hfedarovich/EECD_22_6_main/rc_helicopter_mainboard.kicad_pcb

## KiCad design rc_helicopter_mainboard.kicad_pcb (2023-01-17)

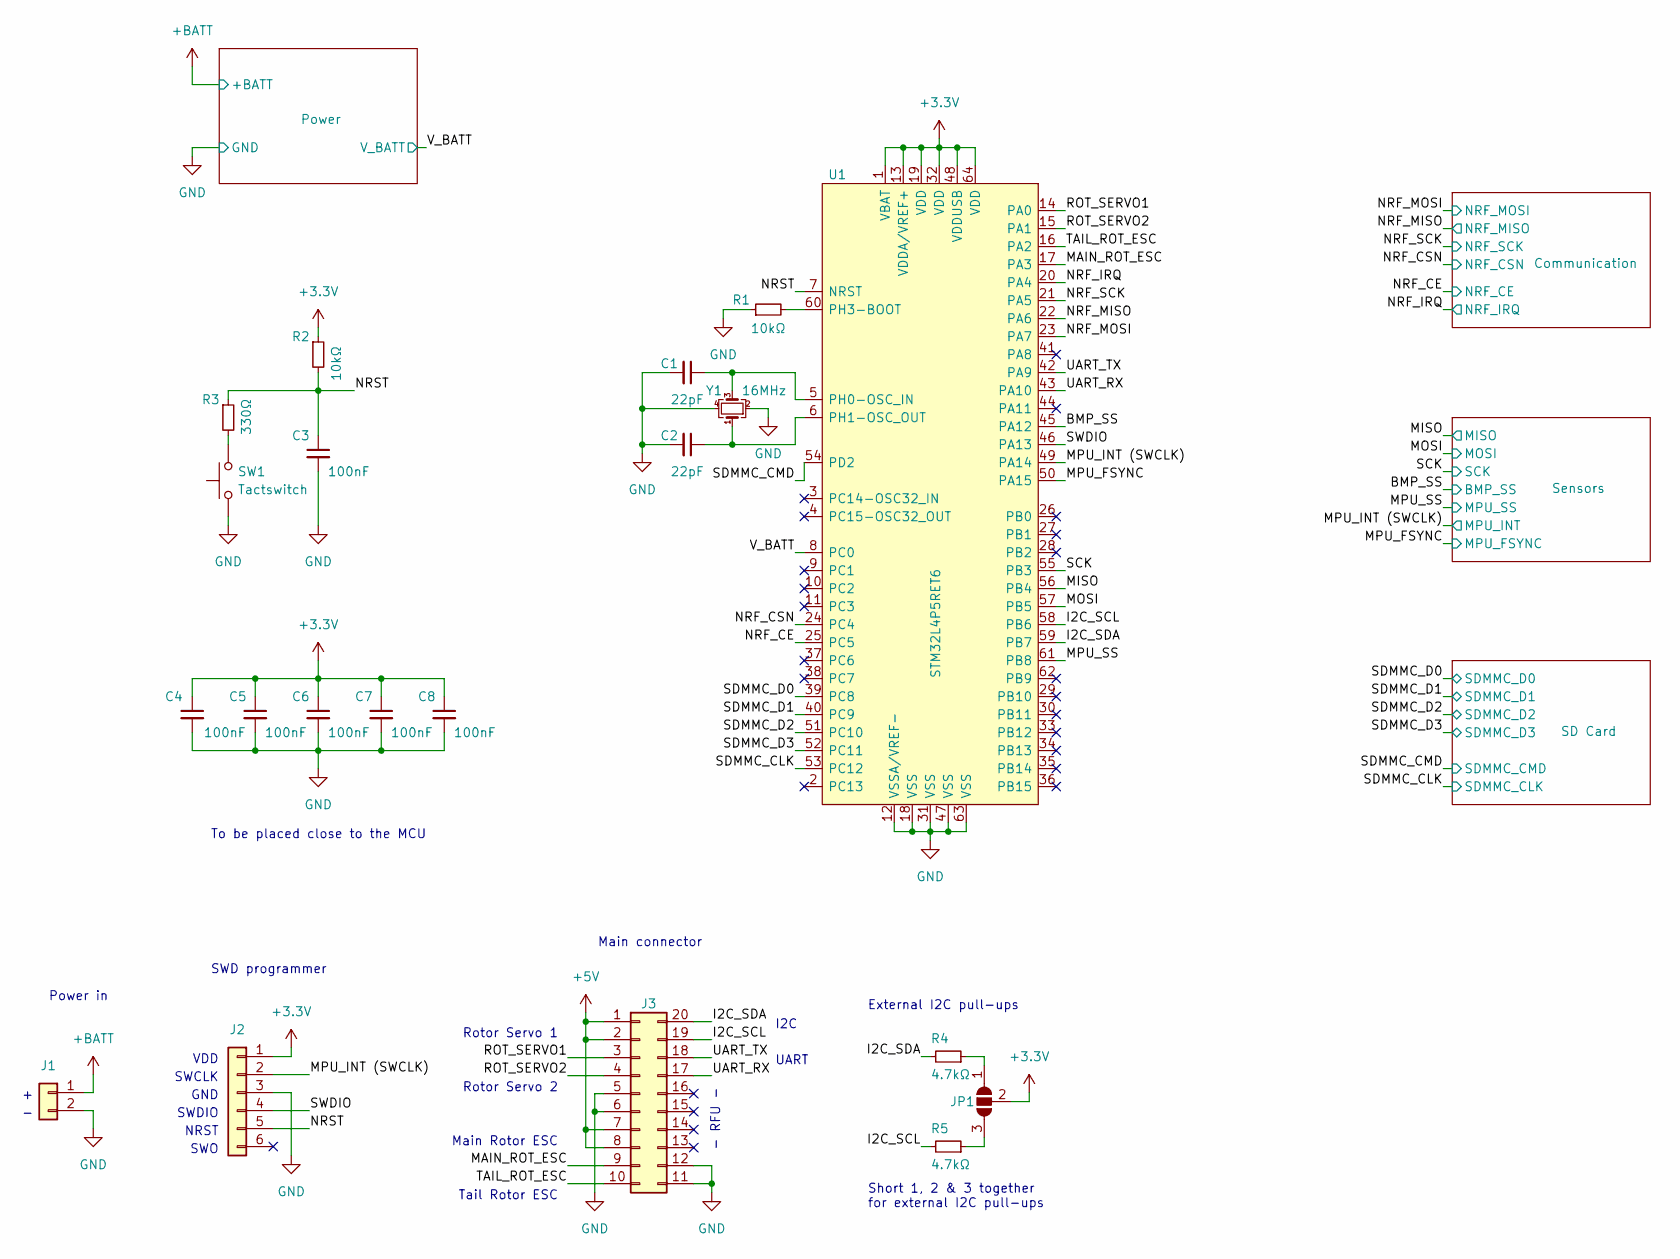
[picture p1: schematic rc_helicopter_mainboard.kicad_sch, RC Helicopter Mainboard]

Parts:
C1, C2: 22pF; C_0603_1608Metric
C3, C4, C5, C6, C7, C8: 100nF; C_0603_1608Metric
J1: Battery Pack; Molex_KK-254_AE-6410-02A_1x02_P2.54mm_Vertical
J2: SWD; PinHeader_2x03_P2.54mm_Vertical
J3: Main Connector; PinHeader_2x10_P2.54mm_Horizontal
JP1: SolderJumper_3_Open; SolderJumper-3_P1.3mm_Open_RoundedPad1.0x1.5mm_NumberLabels
R1, R2: 10kΩ; R_0603_1608Metric
R3: 330Ω; R_0603_1608Metric
R4, R5: 4.7kΩ; R_0603_1608Metric
SW1: Tactswitch; SW_SPST_PTS645
U1: STM32L4P5RET6; LQFP-64_10x10mm_P0.5mm
Y1: 16MHz; Crystal_SMD_3225-4Pin_3.2x2.5mm

Connections:
+3.3V: C4.1, C5.1, C6.1, C7.1, C8.1, J2.1, JP1.2 (C), R2.1, U1.1 (VBAT), U1.13 (VDDA/VREF+), U1.19 (VDD), U1.32 (VDD), U1.48 (VDDUSB), U1.64 (VDD); also elsewhere on the board
+5V: J3.1, J3.2, J3.7, J3.8; also elsewhere on the board
+BATT: J1.1; also elsewhere on the board
/BMP_SS: U1.45 (PA12); also elsewhere on the board
/I2C_SCL: J3.19, R5.2, U1.58 (PB6)
/I2C_SDA: J3.20, R4.2, U1.59 (PB7)
/MAIN_ROT_ESC: J3.9, U1.17 (PA3)
/MISO: U1.56 (PB4); also elsewhere on the board
/MOSI: U1.57 (PB5); also elsewhere on the board
/MPU_FSYNC: U1.50 (PA15); also elsewhere on the board
/MPU_INT (SWCLK): J2.2, U1.49 (PA14); also elsewhere on the board
/MPU_SS: U1.61 (PB8); also elsewhere on the board
/NRF_CE: U1.25 (PC5); also elsewhere on the board
/NRF_CSN: U1.24 (PC4); also elsewhere on the board
/NRF_IRQ: U1.20 (PA4); also elsewhere on the board
/NRF_MISO: U1.22 (PA6); also elsewhere on the board
/NRF_MOSI: U1.23 (PA7); also elsewhere on the board
/NRF_SCK: U1.21 (PA5); also elsewhere on the board
/NRST: C3.1, J2.5, R2.2, R3.1, U1.7 (NRST)
/ROT_SERVO1: J3.3, U1.14 (PA0)
/ROT_SERVO2: J3.4, U1.15 (PA1)
/SCK: U1.55 (PB3); also elsewhere on the board
/SDMMC_CLK: U1.53 (PC12); also elsewhere on the board
/SDMMC_CMD: U1.54 (PD2); also elsewhere on the board
/SDMMC_D0: U1.39 (PC8); also elsewhere on the board
/SDMMC_D1: U1.40 (PC9); also elsewhere on the board
/SDMMC_D2: U1.51 (PC10); also elsewhere on the board
/SDMMC_D3: U1.52 (PC11); also elsewhere on the board
/SWDIO: J2.4, U1.46 (PA13)
/TAIL_ROT_ESC: J3.10, U1.16 (PA2)
/UART_RX: J3.17, U1.43 (PA10)
/UART_TX: J3.18, U1.42 (PA9)
/V_BATT: U1.8 (PC0); also elsewhere on the board
GND: C1.2, C2.2, C3.2, C4.2, C5.2, C6.2, C7.2, C8.2, J1.2, J2.3, J3.5, J3.6, J3.11, J3.12, R1.1, SW1.1, U1.12 (VSSA/VREF-), U1.18 (VSS), U1.31 (VSS), U1.47 (VSS), U1.63 (VSS), Y1.2, Y1.4; also elsewhere on the board
unnamed: C1.1, U1.5 (PH0-OSC_IN), Y1.3
unnamed: C2.1, U1.6 (PH1-OSC_OUT), Y1.1
unnamed: JP1.1 (A), R4.1
unnamed: JP1.3 (B), R5.1
unnamed: R1.2, U1.60 (PH3-BOOT)
unnamed: R3.2, SW1.2

Notes on the sheet:
Tail Rotor ESC
Rotor Servo 1
- RFU -
SWDIO
SWO
NRST
SWCLK
External I2C pull-ups
VDD
To be placed close to the MCU
Main connector
Rotor Servo 2
Short 1, 2 & 3 together for external I2C pull-ups
Power in
SWD programmer
GND
Main Rotor ESC
I2C
UART

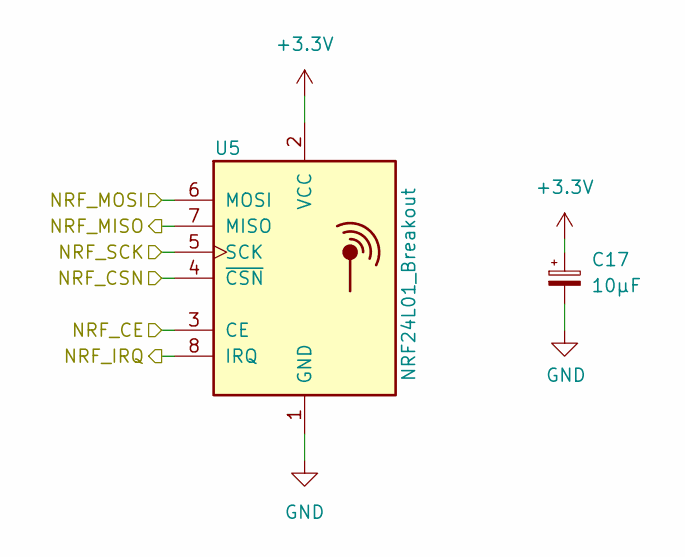
[picture p2: schematic communication.kicad_sch]

Parts:
C17: 10μF; CP_EIA-3216-10_Kemet-I
U5: NRF24L01_Breakout; nRF24L01_Breakout

Connections:
+3.3V: C17.1, U5.2 (VCC); also elsewhere on the board
/NRF_CE: U5.3 (CE); also elsewhere on the board
/NRF_CSN: U5.4 (~CSN); also elsewhere on the board
/NRF_IRQ: U5.8 (IRQ); also elsewhere on the board
/NRF_MISO: U5.7 (MISO); also elsewhere on the board
/NRF_MOSI: U5.6 (MOSI); also elsewhere on the board
/NRF_SCK: U5.5 (SCK); also elsewhere on the board
GND: C17.2, U5.1 (GND); also elsewhere on the board

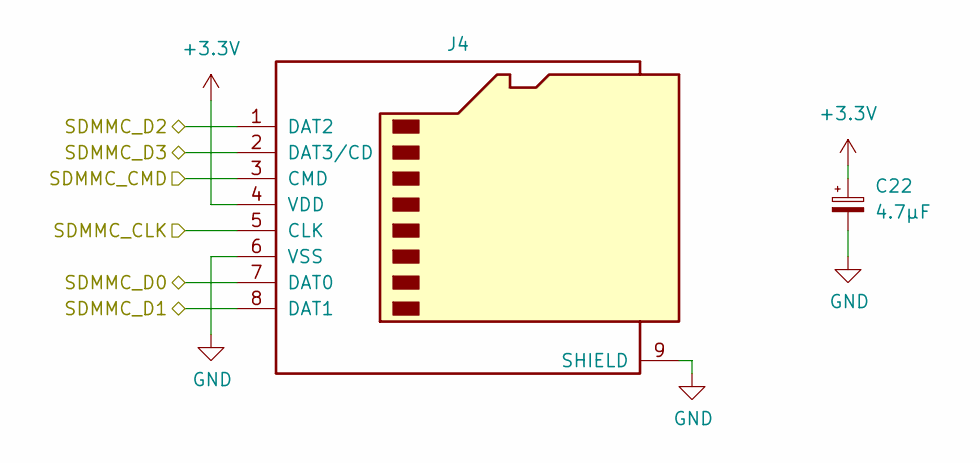
[picture p3: schematic sd_card.kicad_sch, SD Card]

Parts:
C22: 4.7μF; CP_EIA-3216-10_Kemet-I
J4: Micro_SD_Card; 112K-TAA0-RA1

Connections:
+3.3V: C22.1, J4.4 (VDD); also elsewhere on the board
/SDMMC_CLK: J4.5 (CLK); also elsewhere on the board
/SDMMC_CMD: J4.3 (CMD); also elsewhere on the board
/SDMMC_D0: J4.7 (DAT0); also elsewhere on the board
/SDMMC_D1: J4.8 (DAT1); also elsewhere on the board
/SDMMC_D2: J4.1 (DAT2); also elsewhere on the board
/SDMMC_D3: J4.2 (DAT3/CD); also elsewhere on the board
GND: C22.2, J4.6 (VSS), J4.9 (SHIELD); also elsewhere on the board

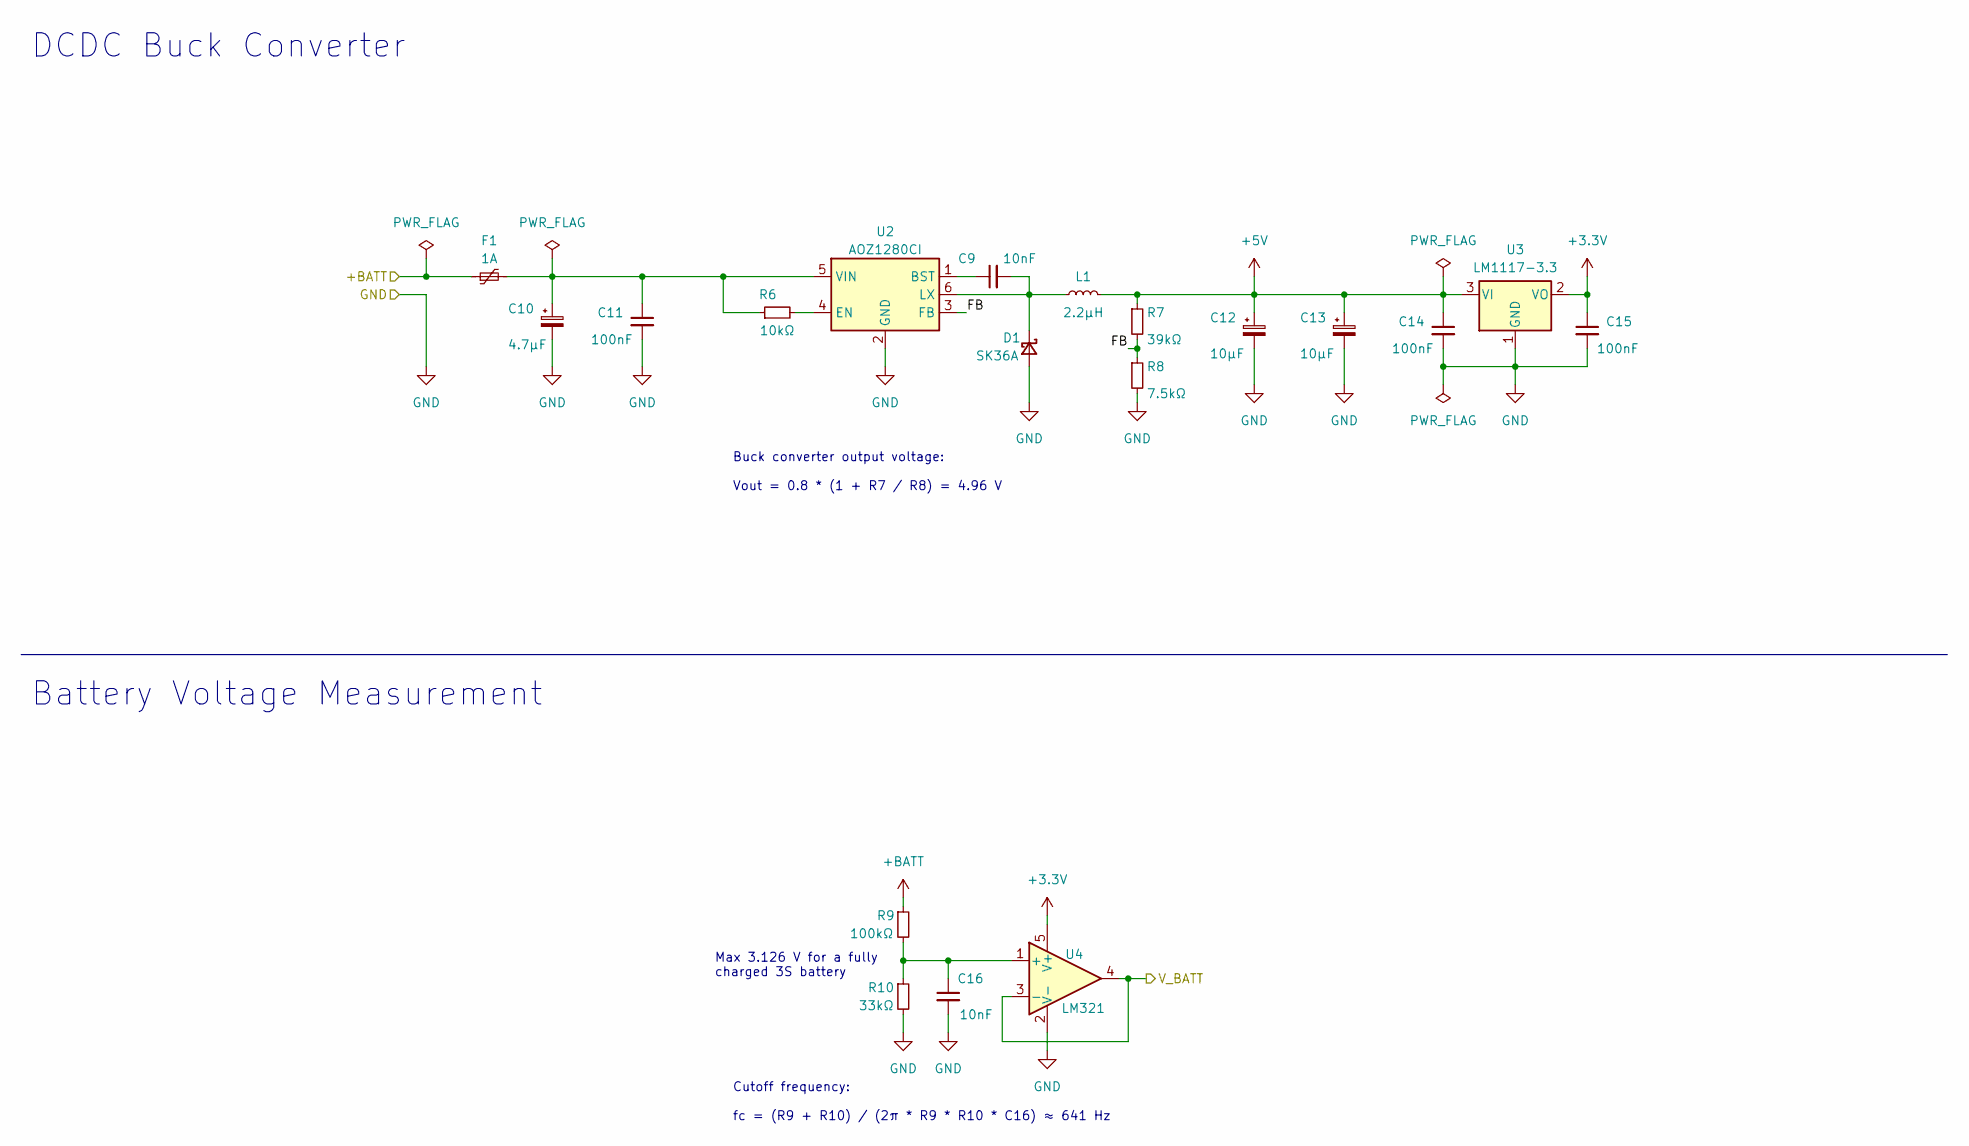
[picture p4: schematic power.kicad_sch, Power Supply]

Parts:
C9, C16: 10nF; C_0603_1608Metric
C10: 4.7μF; CP_Elec_6.3x5.4
C11, C14, C15: 100nF; C_0603_1608Metric
C12: 10μF; CP_Elec_6.3x5.4
C13: 10μF; CP_EIA-3216-10_Kemet-I
D1: SK36A; D_SMA
F1: 1A; Fuse_1210_3225Metric
L1: 2.2μH; L_Bourns-SRN4018
R6: 10kΩ; R_0603_1608Metric
R7: 39kΩ; R_0603_1608Metric
R8: 7.5kΩ; R_0603_1608Metric
R9: 100kΩ; R_0603_1608Metric
R10: 33kΩ; R_0603_1608Metric
U2: AOZ1280CI; SOT-23-6
U3: LM1117-3.3; SOT-223-3_TabPin2
U4: LM321; SOT-23-5

Connections:
+3.3V: C15.1, U3.2 (VO), U4.5 (V+); also elsewhere on the board
+5V: C12.1, C13.1, C14.1, L1.2, R7.1, U3.3 (VI); also elsewhere on the board
+BATT: F1.1, R9.1; also elsewhere on the board
/Power/FB: R7.2, R8.1, U2.3 (FB)
/V_BATT: U4.3 (-), U4.4; also elsewhere on the board
GND: C10.2, C11.2, C12.2, C13.2, C14.2, C15.2, C16.2, D1.2 (A), R8.2, R10.2, U2.2 (GND), U3.1 (GND), U4.2 (V-); also elsewhere on the board
unnamed: C9.1, U2.1 (BST)
unnamed: C9.2, D1.1 (K), L1.1, U2.6 (LX)
unnamed: C10.1, C11.1, F1.2, R6.1, U2.5 (VIN)
unnamed: C16.1, R9.2, R10.1, U4.1 (+)
unnamed: R6.2, U2.4 (EN)

Notes on the sheet:
Max 3.126 V for a fully charged 3S battery
Buck converter output voltage: Vout = 0.8 * (1 + R7 / R8) = 4.96 V
Battery Voltage Measurement
Cutoff frequency: fc = (R9 + R10) / (2π * R9 * R10 * C16) ≈ 641 Hz
DCDC Buck Converter

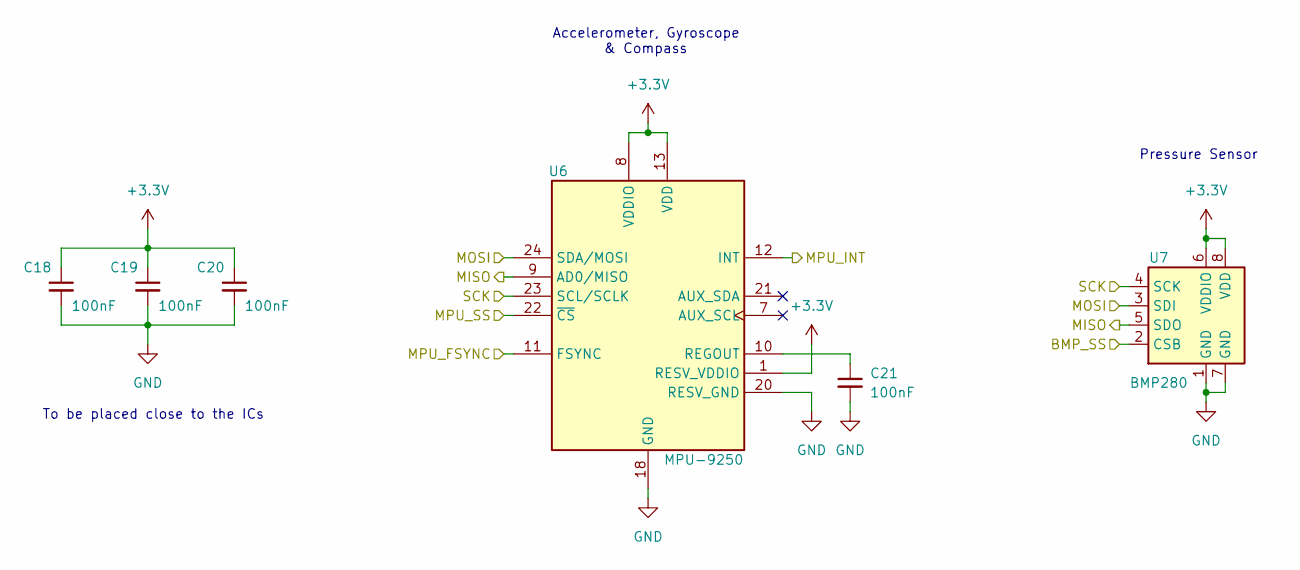
[picture p5: schematic sensors.kicad_sch]

Parts:
C18, C19, C20, C21: 100nF; C_0603_1608Metric
U6: MPU-9250; InvenSense_QFN-24_3x3mm_P0.4mm
U7: BMP280; Bosch_LGA-8_2x2.5mm_P0.65mm_ClockwisePinNumbering

Connections:
+3.3V: C18.1, C19.1, C20.1, U6.1 (RESV_VDDIO), U6.8 (VDDIO), U6.13 (VDD), U7.6 (VDDIO), U7.8 (VDD); also elsewhere on the board
/BMP_SS: U7.2 (CSB); also elsewhere on the board
/MISO: U6.9 (AD0/MISO), U7.5 (SDO); also elsewhere on the board
/MOSI: U6.24 (SDA/MOSI), U7.3 (SDI); also elsewhere on the board
/MPU_FSYNC: U6.11 (FSYNC); also elsewhere on the board
/MPU_INT (SWCLK): U6.12 (INT); also elsewhere on the board
/MPU_SS: U6.22 (~CS); also elsewhere on the board
/SCK: U6.23 (SCL/SCLK), U7.4 (SCK); also elsewhere on the board
GND: C18.2, C19.2, C20.2, C21.2, U6.18 (GND), U6.20 (RESV_GND), U7.1 (GND), U7.7 (GND); also elsewhere on the board
unnamed: C21.1, U6.10 (REGOUT)

Notes on the sheet:
Pressure Sensor
Accelerometer, Gyroscope & Compass
To be placed close to the ICs

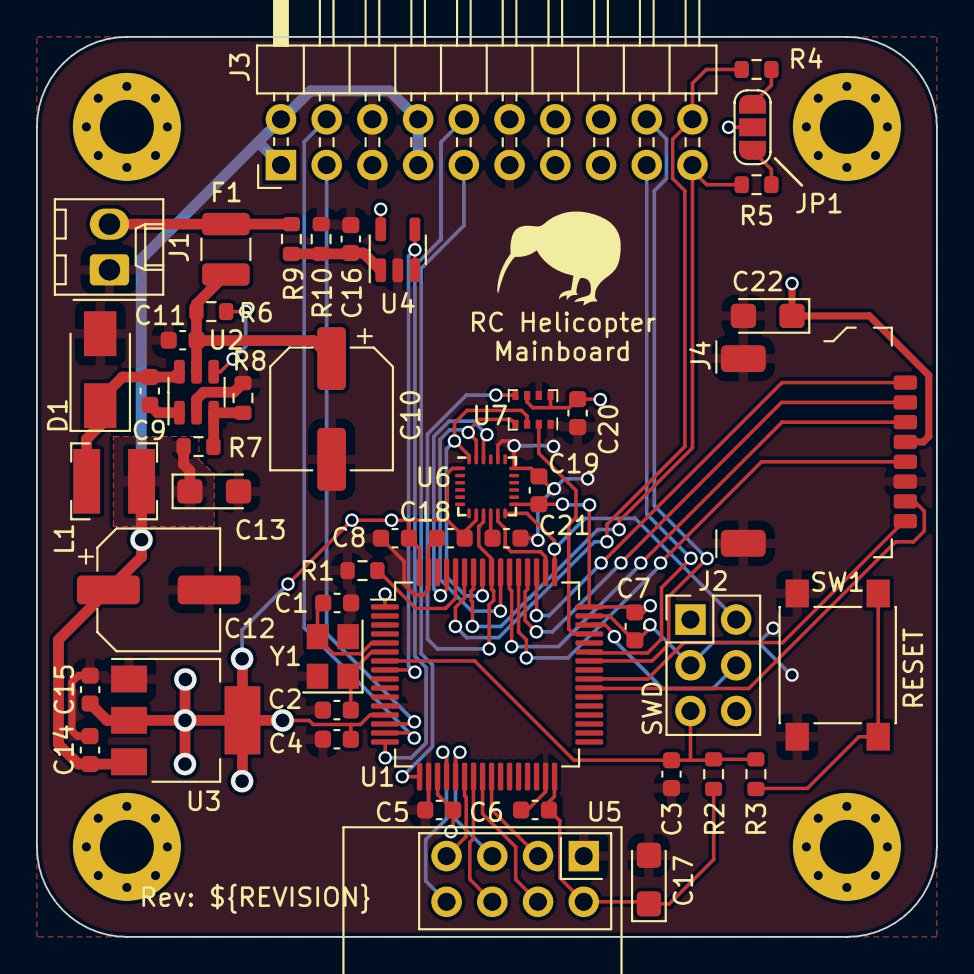
[picture p6: board rc_helicopter_mainboard.kicad_pcb from above]

Board: 2 copper layers, 50.0 x 50.0 mm, 49 parts (0 on the bottom side), 47 nets.
