hfedarovich/EECD_22_6_main/(commit log)

2022-11-22 add functions for sd-card/ems/nrf24
    [helicopter.kicad_sch, power.kicad_sch, sd_card.kicad_sch]
2022-12-12 Refactor the mainboard
    - Use smaller STM
    - Use MPU-9250 as a motion sensor
    - Connect some peripherals to the MCU
    [communication.kicad_sch, connectors.kicad_sch, helicopter.kicad_sch, power.kicad_sch, sd_card.kicad_sch, sensors.kicad_sch]
2022-12-16 Connect sensors to the MCU
    [communication.kicad_sch, connectors.kicad_sch, helicopter.kicad_sch, power.kicad_sch, sd_card.kicad_sch, sensors.kicad_sch]
2022-12-17 Improve the power section:
    - add ADC circuit to measure battery level
    - add 5V LDO regulator
    [communication.kicad_sch, connectors.kicad_sch, helicopter.kicad_sch, power.kicad_sch, sd_card.kicad_sch, sensors.kicad_sch]
2022-12-17 Add external UART and I2C connectors
    [communication.kicad_sch, connectors.kicad_sch, helicopter.kicad_sch]
2022-12-17 Add project logo
    [helicopter.kicad_pcb]
2022-12-17 Assign footprints to symbols
    [communication.kicad_sch, connectors.kicad_sch, helicopter.kicad_pcb, helicopter.kicad_sch, power.kicad_sch, sd_card.kicad_sch, sensors.kicad_sch]
2022-12-17 Rename the project
    [rc_helicopter_mainboard.kicad_pcb, rc_helicopter_mainboard.kicad_sch]
2022-12-22 Use single connector for I/O
    [communication.kicad_sch, connectors.kicad_sch, power.kicad_sch, rc_helicopter_mainboard.kicad_pcb, rc_helicopter_mainboard.kicad_sch, sd_card.kicad_sch, sensors.kicad_sch]
2022-12-23 Remove 5V LDO regulator
    [communication.kicad_sch, power.kicad_sch, rc_helicopter_mainboard.kicad_sch, sd_card.kicad_sch, sensors.kicad_sch]
2022-12-28 Arrange footprints
    [communication.kicad_sch, leds.kicad_sch, power.kicad_sch, rc_helicopter_mainboard.kicad_pcb, rc_helicopter_mainboard.kicad_sch, sd_card.kicad_sch, sensors.kicad_sch]
2022-12-28 Move symbols to a separate directory
    [communication.kicad_sch, leds.kicad_sch, power.kicad_sch, rc_helicopter_mainboard.kicad_pcb, rc_helicopter_mainboard.kicad_sch, sd_card.kicad_sch, sensors.kicad_sch]
2023-01-09 Rearrange footprints
    [rc_helicopter_mainboard.kicad_pcb, rc_helicopter_mainboard.kicad_sch, sensors.kicad_sch]
2023-01-17 Route PCB tracks
    [communication.kicad_sch, leds.kicad_sch, power.kicad_sch, rc_helicopter_mainboard.kicad_pcb, rc_helicopter_mainboard.kicad_sch, sd_card.kicad_sch, sensors.kicad_sch]
2023-01-17 Release v1.0.0
    [rc_helicopter_mainboard.kicad_pcb]
